1c3d1v3r/neatPLA/gerbers/README.md

R1 gerbers are the original ones released in 2020. R2 gerbers have been edited to match JLCpcb rules.<br/>
Holes under top silk have been moved. Teardrops added.<br/>
Now also BOM and CPL files are included for SMD assembly service. You can use them at PCBway or JLCpcb. <br/>
PCBway project have been updated with latest files https://www.pcbway.com/project/shareproject/neatPLA_for_Commodore_64.html<br/>
Order with black soldermask. Select "Remove product No." or "Remove mark" as there is no defined place for the order number and manufacturer may place it to top.
