1c3d1v3r/neatPLA/gerbers/BOM_neatPLA_R2.xlsx

Comment | Designator | Footprint | JLCPCB Part #
2.2uF | C1, C2 | 0805 | C28234
220nF | C3 | 0805 | C5378
XC9536XL | U1 | 44-TQFP, 44-VQFP | C124132
MCP1702 | U2 | SC-59, SOT-23-3, SOT-23A-3 | C625365
