1c3d1v3r/neatPLA/Schematic_neatPLA.pdf

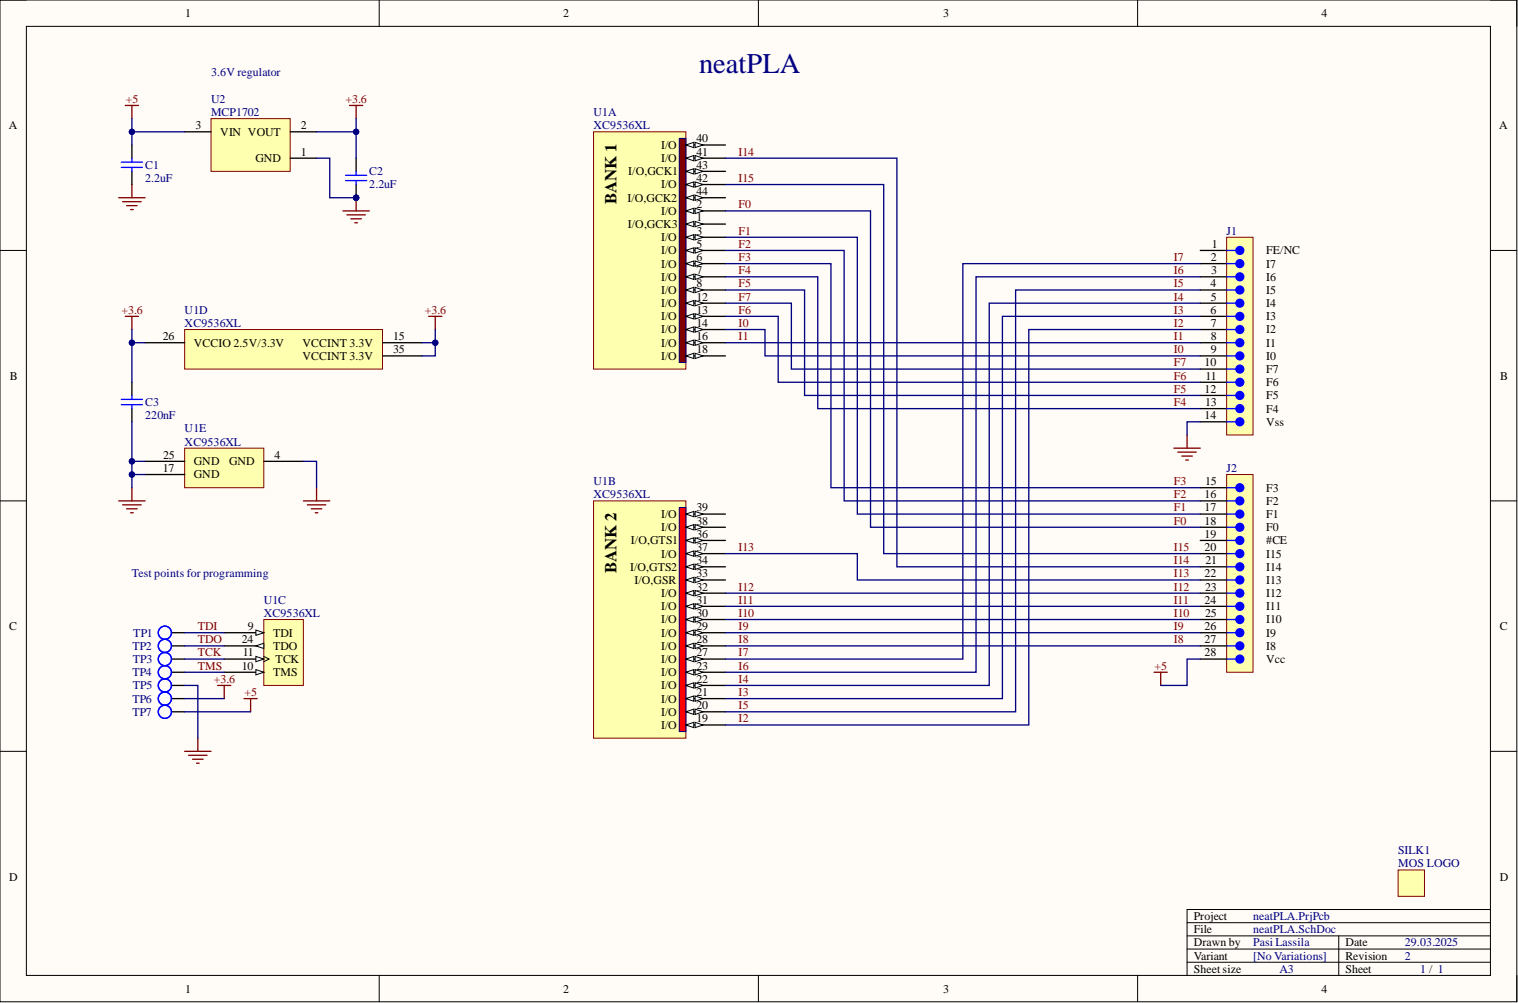
[picture p9: page 1]

2 2 | I4
2 1 | I3
2 0 | I5
1 9 | I2
