1c3d1v3r/neatPLA/original_dodgyPLA_fix/README.md

These files can be used to update dodgyPLA with the timing fixes of neatPLA.
Do not use for neatPLA as it got different pinout.

What is changed compared to dodgyPLA:
- CASRAM delay increased to 30ns. Fixes timing issues with motherboard 326298
- Added extra delay to all outputs. Fixes a timing issue with motherboard 250407/250425 + SwinSID
