1c3d1v3r/neatPLA/(commit log)

2020-04-25 Deleted dodgyPLA files. To be replaced with neatPLA files.
    [dodgypla.kicad_pcb, dodgypla.sch]
2020-04-25 Added gerbers, drill file & schematic
    [neatPLA.GBL, neatPLA.GBO, neatPLA.GBS, neatPLA.GTL, neatPLA.GTO, neatPLA.GTS]
2020-04-30 Added PCBway link
2025-03-31 Add files via upload
    Uploaded gerbers, BOM & PP files
    [Bill of Materials-neatPLA_R2.xlsx, Pick Place for neatPLA_R2.xlsx]
